DrFlGd/Cycloidal-Drive/docs/data/validation_matrix.csv

preset | simplification_level | input_shaft_mode | coupled_eccentric_mode | status | message | housing_od_mm | ring_pitch_r_mm | pitch_growth_mm | output_face_od_mm | depth_mm | facet_error_mm | undercut_margin_mm | min_shaft_mm | front_support | rear_support | warnings
NEMA17 Commodity R15 | Full hardware | Direct motor shaft | Separate eccentric sleeves | PASS |  | 120 | 44.5 | 0 | 82 | 45.7 | 0.000467883 | 5.64053 | 20.45 | 607ZZ = 7x19x6 mm in hub pocket 18.985 mm
NEMA17 Commodity R15 | Full hardware | Machined coupled shaft | Separate eccentric sleeves | PASS |  | 120 | 44.5 | 0 | 82 | 70.2 | 0.000467883 | 5.64053 |  | 607ZZ = 7x19x6 mm in hub pocket 18.985 mm | 6801VV = 12x21x5 mm in spacer pocket 20.985 mm at z=-6
NEMA17 Commodity R15 | Full hardware | Machined coupled shaft | Integrated double eccentric | PASS |  | 120 | 44.5 | 0 | 82 | 70.2 | 0.000467883 | 5.64053 |  | 625ZZ = 5x16x5 mm in hub pocket 15.985 mm | NONE
NEMA17 Commodity R15 | Integrated case lobes | Direct motor shaft | Separate eccentric sleeves | PASS |  | 120 | 44.5 | 0 | 82 | 45.7 | 0.000463448 | 5.43053 | 20.45 | 607ZZ = 7x19x6 mm in hub pocket 19.15 mm
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
