DrFlGd/Cycloidal-Drive/(commit log)

2026-09-24 Add project documentation and v1.6 manufacturing data
    [CUT_LIST_NEMA17_15_COMMODITY_FULL_HARDWARE_v1_6.csv, HARDWARE_BOM_NEMA17_15_COMMODITY_FULL_HARDWARE_v1_6.csv, HARDWARE_BY_SIMPLIFICATION_NEMA17_15_v1_6.csv, PROFILE_GUIDE_v1_6.csv]
2026-09-24 Materialize standalone OpenSCAD v1.6 source
    [cnc_nema_cycloidal_gearbox_pancake_v1_6.scad]
2026-09-24 Clean temporary source materialization files
2026-09-25 Add v1.8 case-rooted lobes and editable preset architecture
    [cnc_nema_cycloidal_gearbox_pancake_v1_8.scad]
2026-09-25 Document v1.8 editable presets
    [PROFILE_GUIDE_v1_8.csv]
2026-09-25 Document v1.8 simplification levels
    [SIMPLIFICATION_GUIDE_v1_8.csv]
2026-09-25 Add v1.8 40-case geometry validation matrix
    [profile_simplification_validation_v1_8.csv]
2026-09-25 Add v1.9 coupled input shaft architecture
    [cnc_nema_cycloidal_gearbox_pancake_v1_9.scad]
2026-09-25 Add editable v1.9 input shaft preset values
2026-09-25 Document v1.9 coupled shaft preset dimensions
    [PROFILE_GUIDE_v1_9.csv]
2026-09-25 Add v1.9 input shaft option guide
    [INPUT_SHAFT_OPTIONS_v1_9.csv]
2026-09-25 Add v1.9 80-case validation matrix
    [profile_input_simplification_validation_v1_9.csv]
2026-09-25 Document v1.9 coupled input shaft option
2026-09-25 Add v1.10 integrated double-eccentric input shaft
    [cnc_nema_cycloidal_gearbox_pancake_v1_10.scad]
2026-09-25 Add v1.10 editable integrated-shaft presets
2026-09-25 Add v1.10 profile guide
    [PROFILE_GUIDE_v1_10.csv]
2026-09-25 Document v1.10 input shaft options
    [INPUT_SHAFT_OPTIONS_v1_10.csv]
2026-09-25 Document integrated double-eccentric shaft
2026-09-25 Add v1.10 validation matrix
    [profile_input_eccentric_simplification_validation_v1_10.csv]
2026-09-25 Document v1.10 integrated eccentric shaft
2026-10-25 Fix cycloid geometry, printed fits, eccentric sleeves and part export (v1.11)
    Geometry
    - Assert an odd lobe count: the second disc is the first turned 180 degrees and
    only meshes for odd N. NEMA23 Medium R18 (which interfered by 2.96 mm) becomes
    R19; the ratio dropdown offers 19 instead of 18.
    - Resample the cycloid profile by curvature-weighted arc length so facet error
    is uniform (about 0.001-0.004 mm at 1200 points) instead of reaching 0.36 mm
    in the valleys on the large presets. The build report echoes the estimate.
    - New assertions: undercut margin, ring-packing pitch growth, direct-shaft
    protrusion, tie bolts inside the case wall, sleeve collar clearance, and the
    two-sleeve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
    [INPUT_SHAFT_OPTIONS_v1_11.csv, PROFILE_GUIDE_v1_11.csv, cnc_nema_cycloidal_gearbox_pancake_v1_10.scad, profile_input_eccentric_simplification_validation_v1_11.csv]
2026-10-26 Add input support bearings and fix the hub ring stack (v1.12)
    The eccentric input was cantilevered from the motor bearings. The one-piece
    sleeve or the coupled shaft now continues into a front pilot bearing seated
    in the rear face of the output hub ring and retained by the inner race
    retainer; the coupled shaft with separate sleeves also gets a rear support
    bearing on its coupling hub inside the motor spacer.
    - input_front_support / front_pilot_bearing_select with automatic size
    descent: pocket inside the clamp-screw circle, journal through the output
    centre bore, journal small enough for the front eccentric bearing to pass
    over it (bore minus twice the eccentricity), and 0.8 mm of wa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
    [INPUT_SHAFT_OPTIONS_v1_12.csv, cnc_nema_cycloidal_gearbox_pancake_v1_10.scad, profile_input_eccentric_simplification_validation_v1_12.csv]
2026-10-26 Split the design into library files, remove legacy paths, add CI validation (v1.13)
    One design file plus libraries: src/cycloidal_gearbox.scad keeps the
    Customizer parameters and the part selector; src/lib/ holds catalog,
    derived geometry, cycloid math, checks, report, 2D parts, 3D parts and
    views. Presets move to src/cycloidal_gearbox.json. The versioned copies
    (v1_6, v1_8, v1_9, v1_10) are removed; tags v1.10, v1.11 and v1.12 mark
    those versions.
    Legacy paths removed: hardware_catalog_mode, use_frame_preset and the
    custom_* motor fields for NEMA frames, ratio_preset/custom_ratio (now
    reduction_ratio), ring_roller_system with the compact-sleeve baseline,
    printed_ring_feature_style bridges,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
    [CUT_LIST_NEMA17_15_COMMODITY_FULL_HARDWARE_v1_6.csv, HARDWARE_BOM_NEMA17_15_COMMODITY_FULL_HARDWARE_v1_6.csv, HARDWARE_BY_SIMPLIFICATION_NEMA17_15_v1_6.csv, INPUT_SHAFT_OPTIONS.csv, INPUT_SHAFT_OPTIONS_v1_10.csv, INPUT_SHAFT_OPTIONS_v1_11.csv, INPUT_SHAFT_OPTIONS_v1_9.csv, PROFILE_GUIDE.csv]
2026-10-26 Render the motion GIF one frame per process
    OpenSCAD's --animate aborts with an X BadRequest error under the GitHub
    runner's Xvfb (the stills in the same job render fine), so the frames are
    now rendered with one process each and $t passed on the command line.
    Claude-Session: https://claude.ai/code/session_01B4Mt57PoAHimUgghrGjWbA
2026-10-26 Add a browser-based generator for the cycloidal gearbox
    web/ runs src/cycloidal_gearbox.scad in the browser through OpenSCAD 2025
    compiled to WebAssembly, so the page and the desktop Customizer share one
    design file. The page is split into three panels:
    - Configure: presets, then the Customizer parameters grouped by function
    with plain-language labels and help, settings the current build does not
    use hidden, per-field change markers and reset, search, an advanced
    toggle, and save/load of Customizer parameter sets, share links and an
    OpenSCAD project download.
    - Preview: assembly, exploded, input stack, parts layout, 2D profiles or any
    single part (3D solid or 2D profile), with a s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
